HPMR-24-25/HPMR-VANGUARD/VanguardFlightComputer.kicad_pcb

## KiCad design VanguardFlightComputer.kicad_pcb (2024-11-11)

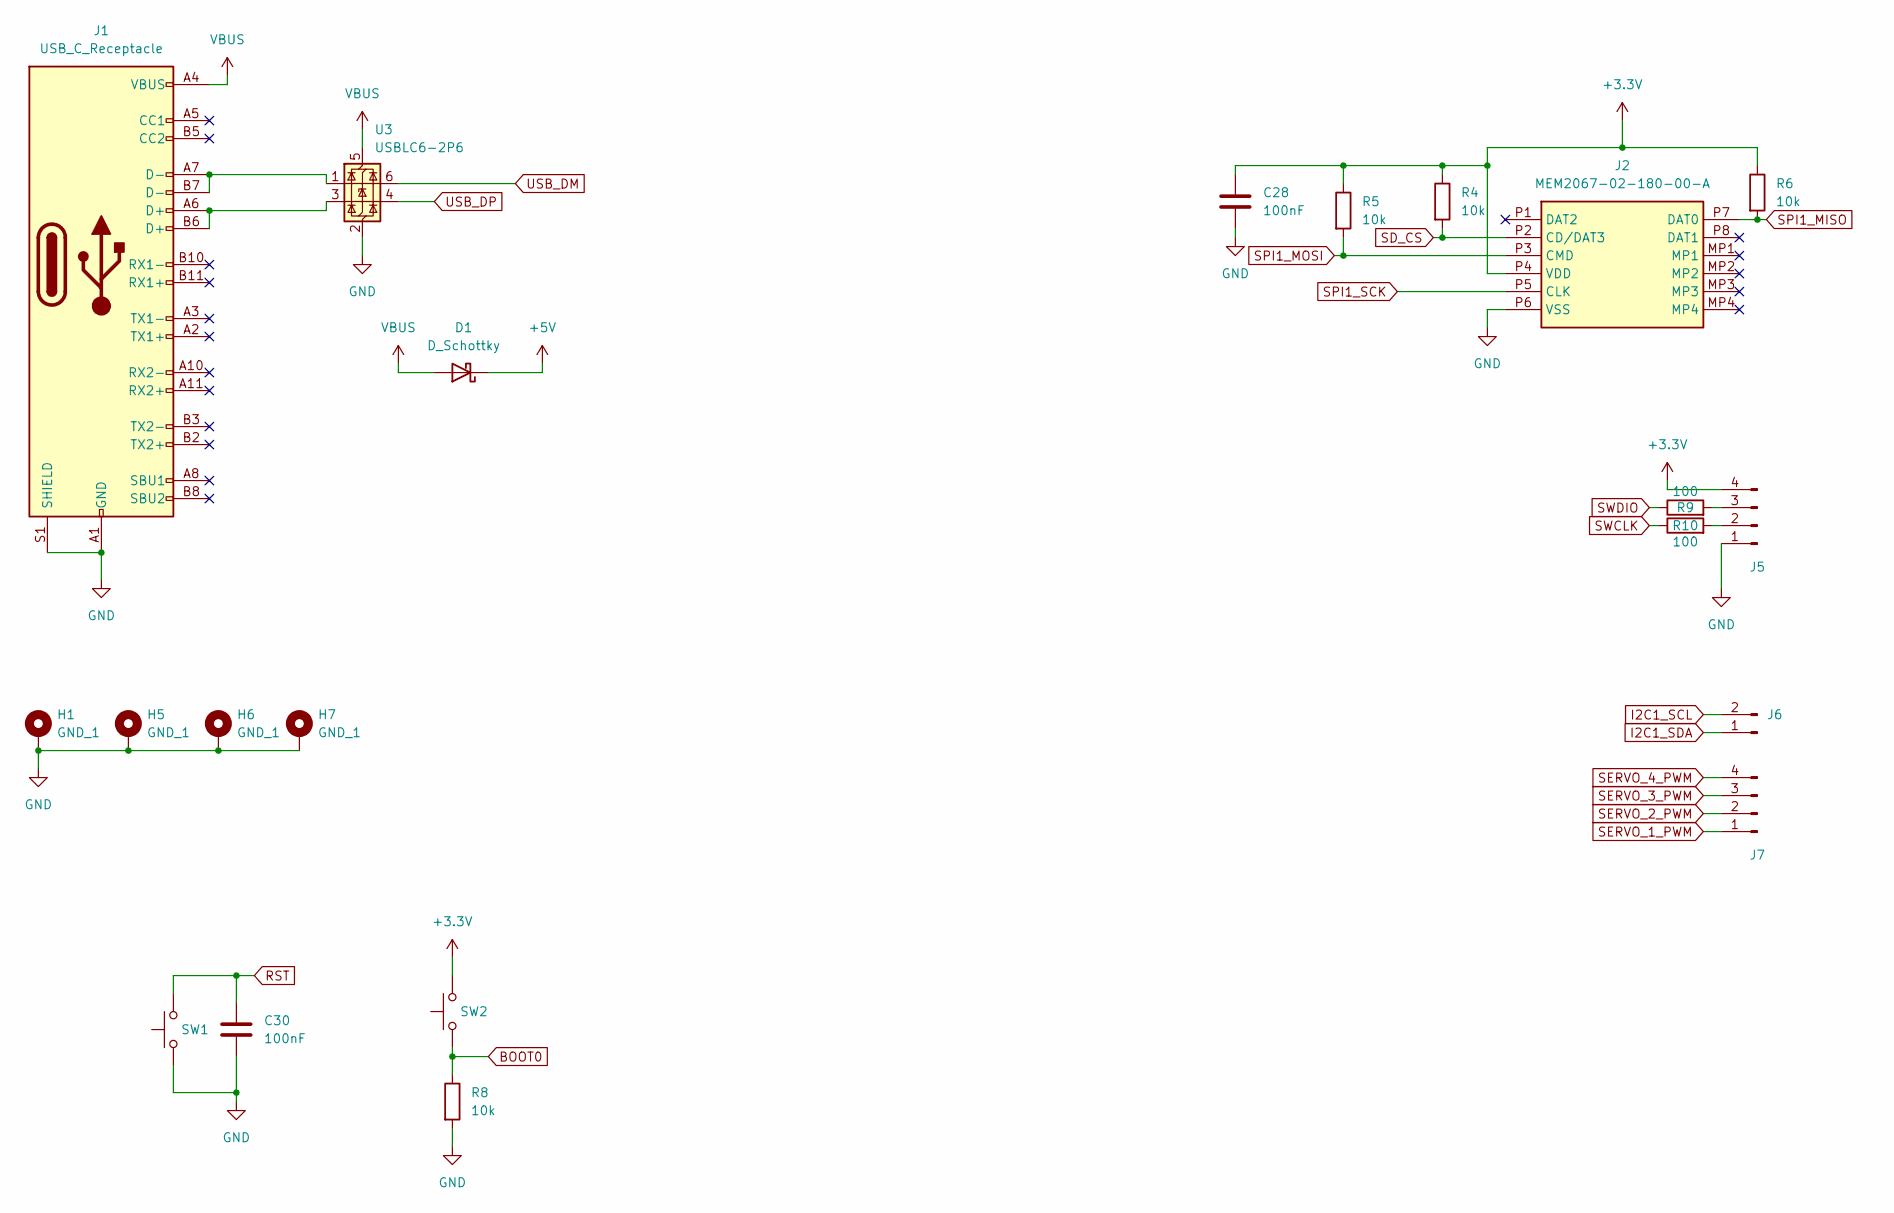
[picture p1: schematic io.kicad_sch]

Parts:
C28, C30: 100nF; C_0402_1005Metric
D1: D_Schottky; D_0402_1005Metric
H1, H5, H6, H7: GND_1; MountingHole_2.2mm_M2_DIN965_Pad_TopBottom
J1: USB_C_Receptacle; USB_C_Receptacle_Molex_105450-0101
J2: MEM2067-02-180-00-A; MEM20670218000A; Manufacturer_Part_Number MEM2067-02-180-00-A; Mouser Part Number 640-MEM20670218000A
J5, J7: Conn_01x04_Pin; PinSocket_1x04_P2.54mm_Vertical
J6: Conn_01x02_Pin; PinHeader_1x02_P2.54mm_Vertical
R4, R5, R6, R8: 10k; R_0402_1005Metric
R9, R10: 100; R_0402_1005Metric
SW1, SW2: SW_Push; SW_SPST_PTS810
U3: USBLC6-2P6; SOT-666

Connections:
+3.3V: C28.1, J2.P4 (VDD), J5.4, R4.1, R5.1, R6.1, SW2.2; also elsewhere on the board
+5V: D1.1 (K); also elsewhere on the board
BOOT0: R8.1, SW2.1; also elsewhere on the board
GND: C28.2, C30.2, H1.MP, H5.MP, H6.MP, H7.MP, J1.A1 (GND), J1.A12 (GND), J1.B1 (GND), J1.B12 (GND), J1.S1 (SHIELD), J2.P6 (VSS), J5.1, R8.2, SW1.1, U3.2 (GND); also elsewhere on the board
I2C1_SCL: J6.2; also elsewhere on the board
I2C1_SDA: J6.1; also elsewhere on the board
unnamed: J1.A6 (D+), J1.B6 (D+), U3.3 (I/O2)
unnamed: J1.A7 (D-), J1.B7 (D-), U3.1 (I/O1)
unnamed: J5.2, R10.2
unnamed: J5.3, R9.2
RST: C30.1, SW1.2; also elsewhere on the board
SD_CS: J2.P2 (CD/DAT3), R4.2; also elsewhere on the board
SERVO_1_PWM: J7.1; also elsewhere on the board
SERVO_2_PWM: J7.2; also elsewhere on the board
SERVO_3_PWM: J7.3; also elsewhere on the board
SERVO_4_PWM: J7.4; also elsewhere on the board
SPI1_MISO: J2.P7 (DAT0), R6.2; also elsewhere on the board
SPI1_MOSI: J2.P3 (CMD), R5.2; also elsewhere on the board
SPI1_SCK: J2.P5 (CLK); also elsewhere on the board
SWCLK: R10.1; also elsewhere on the board
SWDIO: R9.1; also elsewhere on the board
USB_DM: U3.6 (I/O1); also elsewhere on the board
USB_DP: U3.4 (I/O2); also elsewhere on the board
VBUS: D1.2 (A), J1.A4 (VBUS), J1.A9 (VBUS), J1.B4 (VBUS), J1.B9 (VBUS), U3.5 (VBUS)

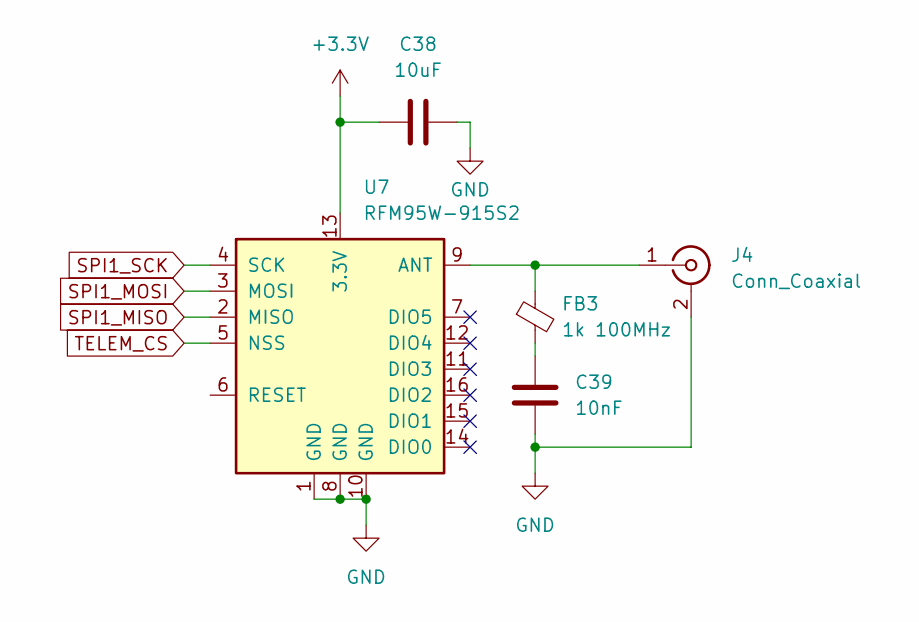
[picture p2: schematic Telemetry.kicad_sch]

Parts:
C38: 10uF; C_0402_1005Metric
C39: 10nF; C_0402_1005Metric
FB3: 1k 100MHz; C_0603_1608Metric
J4: Conn_Coaxial; U.FL_Hirose_U.FL-R-SMT-1_Vertical
U7: RFM95W-915S2; HOPERF_RFM9XW_SMD

Connections:
+3.3V: C38.1, U7.13 (3.3V); also elsewhere on the board
GND: C38.2, C39.2, J4.2 (Ext), U7.1 (GND), U7.8 (GND), U7.10 (GND); also elsewhere on the board
unnamed: C39.1, FB3.2
unnamed: FB3.1, J4.1 (In), U7.9 (ANT)
SPI1_MISO: U7.2 (MISO); also elsewhere on the board
SPI1_MOSI: U7.3 (MOSI); also elsewhere on the board
SPI1_SCK: U7.4 (SCK); also elsewhere on the board
TELEM_CS: U7.5 (NSS); also elsewhere on the board

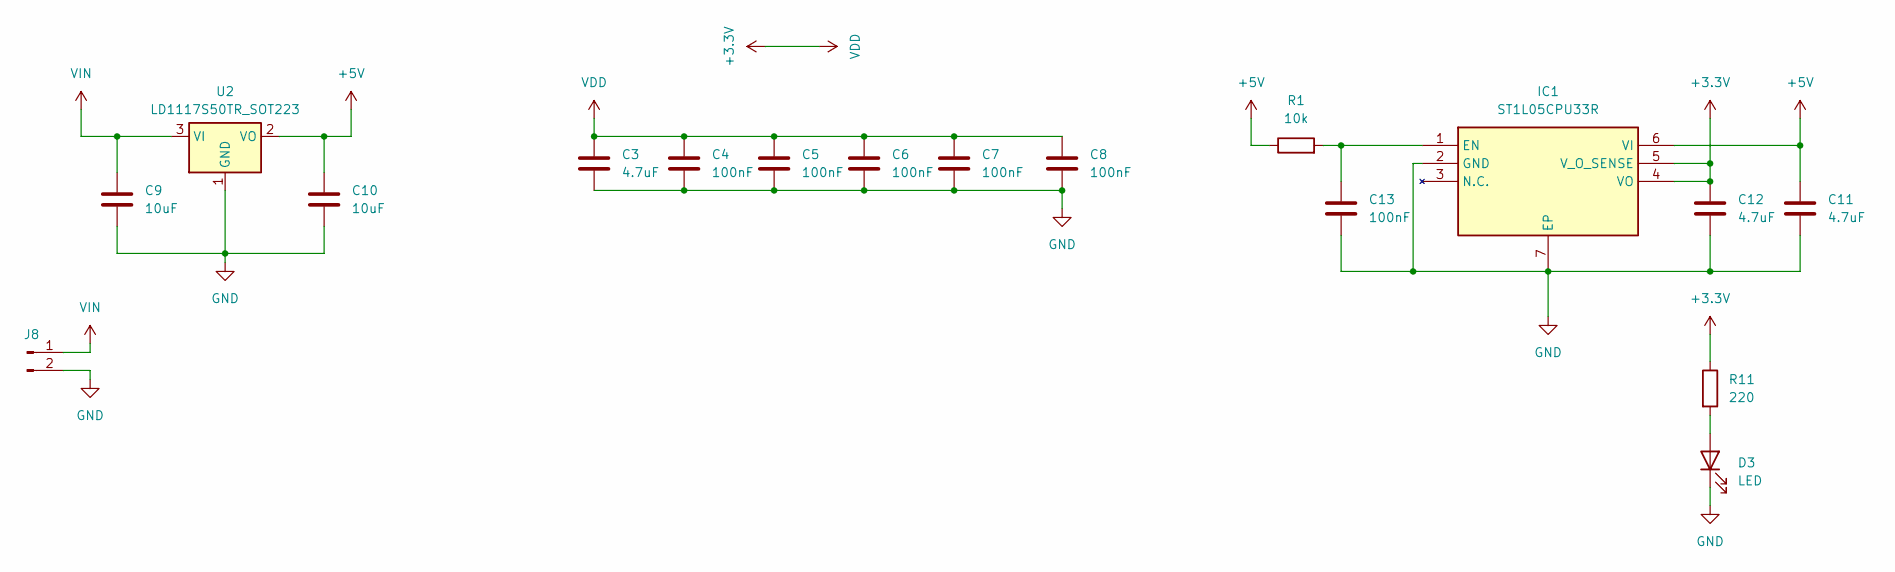
[picture p3: schematic power.kicad_sch]

Parts:
C3, C11, C12: 4.7uF; C_0402_1005Metric
C4, C5, C6, C7, C8, C13: 100nF; C_0402_1005Metric
C9, C10: 10uF; C_0603_1608Metric
D3: LED; LED_0603_1608Metric
IC1: ST1L05CPU33R; SON95P300X300X100-7N-D; Manufacturer_Part_Number ST1L05CPU33R; Mouser Part Number 511-ST1L05CPU33R
J8: Conn_01x02_Pin; PinHeader_1x02_P2.54mm_Vertical
R1: 10k; R_0603_1608Metric
R11: 220; R_0402_1005Metric
U2: LD1117S50TR_SOT223; SOT-223-3_TabPin2

Connections:
+3.3V: C3.1, C4.1, C5.1, C6.1, C7.1, C8.1, C12.1, IC1.4 (VO), IC1.5 (V_O_SENSE), R11.1; also elsewhere on the board
+5V: C10.1, C11.1, IC1.6 (VI), R1.1, U2.2 (VO); also elsewhere on the board
GND: C3.2, C4.2, C5.2, C6.2, C7.2, C8.2, C9.2, C10.2, C11.2, C12.2, C13.2, D3.1 (K), IC1.2 (GND), IC1.7 (EP), J8.2, U2.1 (GND); also elsewhere on the board
unnamed: D3.2 (A), R11.2
unnamed: C13.1, IC1.1 (EN), R1.2
VIN: C9.1, J8.1, U2.3 (VI)

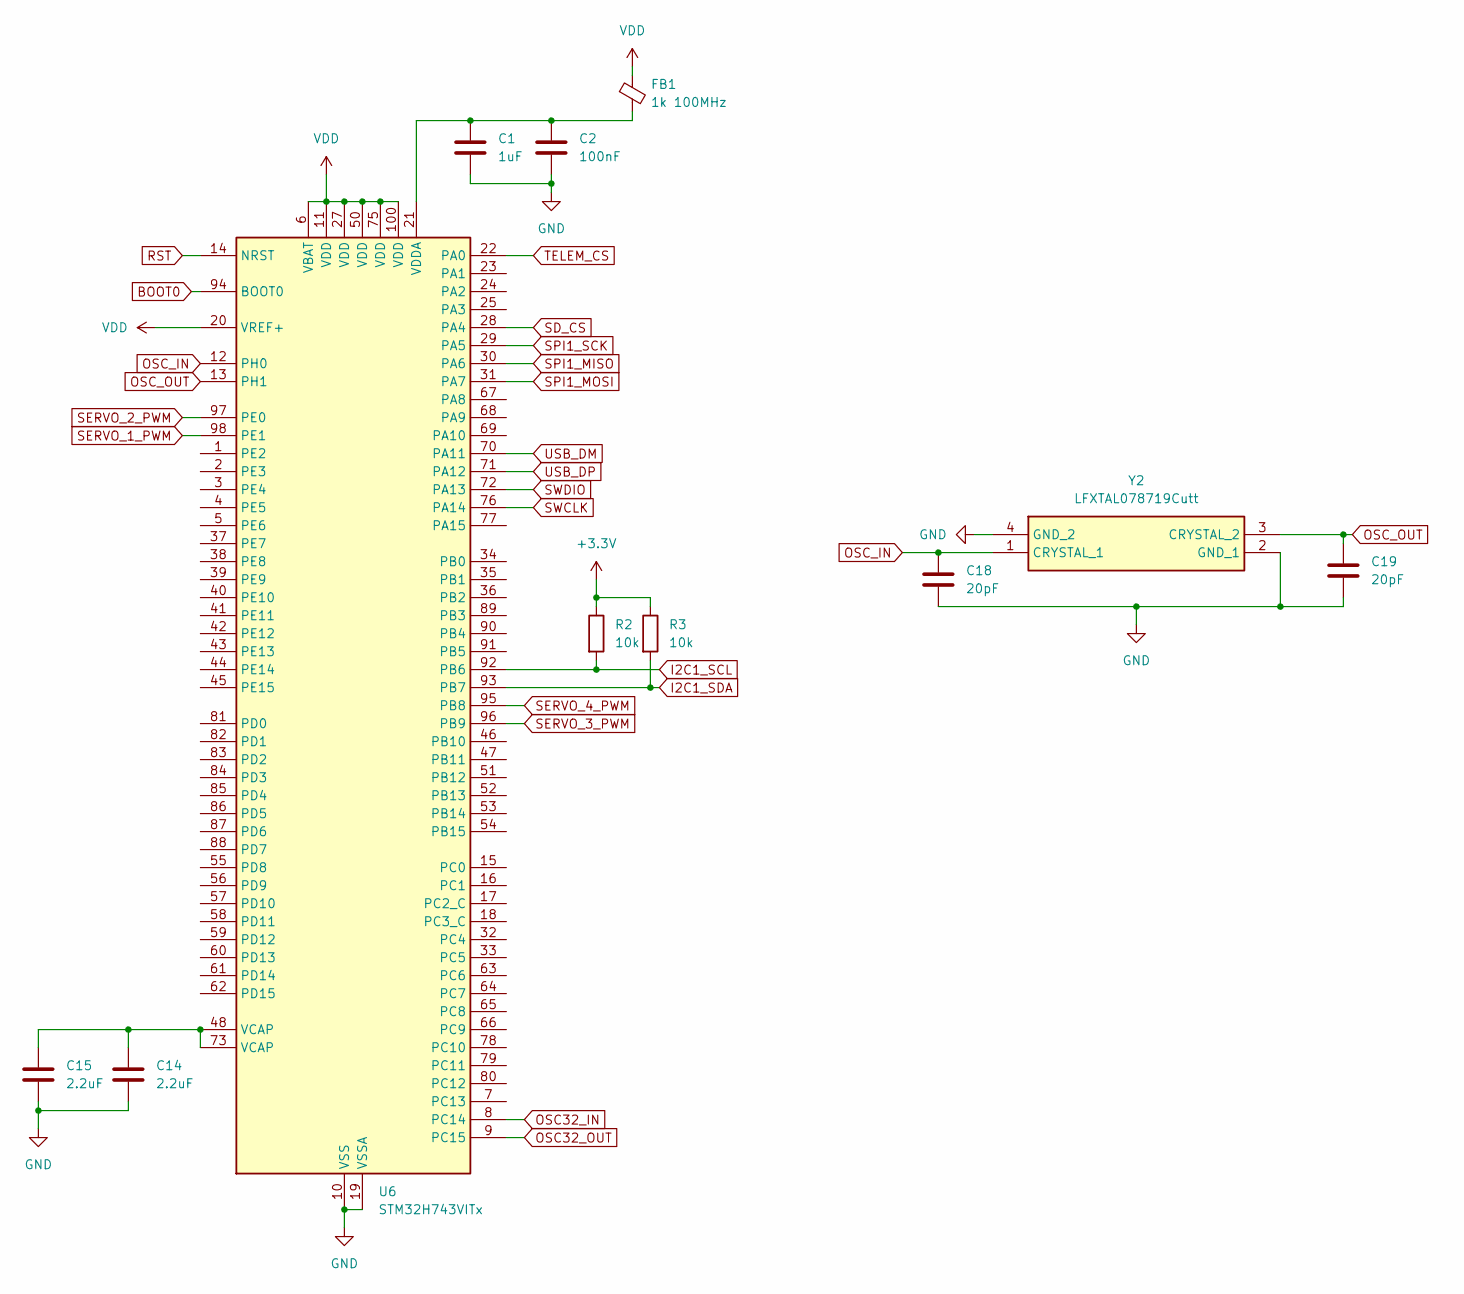
[picture p4: schematic stm32.kicad_sch]

Parts:
C1: 1uF; C_0402_1005Metric
C2: 100nF; C_0402_1005Metric
C14, C15: 2.2uF; C_0402_1005Metric
C18, C19: 20pF; C_0402_1005Metric
FB1: 1k 100MHz; C_0603_1608Metric
R2, R3: 10k; R_0402_1005Metric
U6: STM32H743VITx; LQFP-100_14x14mm_P0.5mm
Y2: LFXTAL078719Cutt; Manufacturer_Part_Number LFXTAL078719Cutt; Mouser Part Number 449-LFXTAL078719CUTT

Connections:
+3.3V: FB1.1, R2.1, R3.1, U6.6 (VBAT), U6.11 (VDD), U6.20 (VREF+), U6.27 (VDD), U6.50 (VDD), U6.75 (VDD), U6.100 (VDD); also elsewhere on the board
BOOT0: U6.94 (BOOT0); also elsewhere on the board
GND: C1.2, C2.2, C14.2, C15.2, C18.1, C19.1, U6.10 (VSS), U6.19 (VSSA), U6.26 (VSS), U6.49 (VSS), U6.74 (VSS), U6.99 (VSS), Y2.2 (GND_1), Y2.4 (GND_2); also elsewhere on the board
I2C1_SCL: R2.2, U6.92 (PB6); also elsewhere on the board
I2C1_SDA: R3.2, U6.93 (PB7); also elsewhere on the board
unnamed: C14.1, C15.1, U6.48 (VCAP), U6.73 (VCAP)
unnamed: C1.1, C2.1, FB1.2, U6.21 (VDDA)
OSC32_IN: U6.8 (PC14)
OSC32_OUT: U6.9 (PC15)
OSC_IN: C18.2, U6.12 (PH0), Y2.1 (CRYSTAL_1)
OSC_OUT: C19.2, U6.13 (PH1), Y2.3 (CRYSTAL_2)
RST: U6.14 (NRST); also elsewhere on the board
SD_CS: U6.28 (PA4); also elsewhere on the board
SERVO_1_PWM: U6.98 (PE1); also elsewhere on the board
SERVO_2_PWM: U6.97 (PE0); also elsewhere on the board
SERVO_3_PWM: U6.96 (PB9); also elsewhere on the board
SERVO_4_PWM: U6.95 (PB8); also elsewhere on the board
SPI1_MISO: U6.30 (PA6); also elsewhere on the board
SPI1_MOSI: U6.31 (PA7); also elsewhere on the board
SPI1_SCK: U6.29 (PA5); also elsewhere on the board
SWCLK: U6.76 (PA14); also elsewhere on the board
SWDIO: U6.72 (PA13); also elsewhere on the board
TELEM_CS: U6.22 (PA0); also elsewhere on the board
USB_DM: U6.70 (PA11); also elsewhere on the board
USB_DP: U6.71 (PA12); also elsewhere on the board

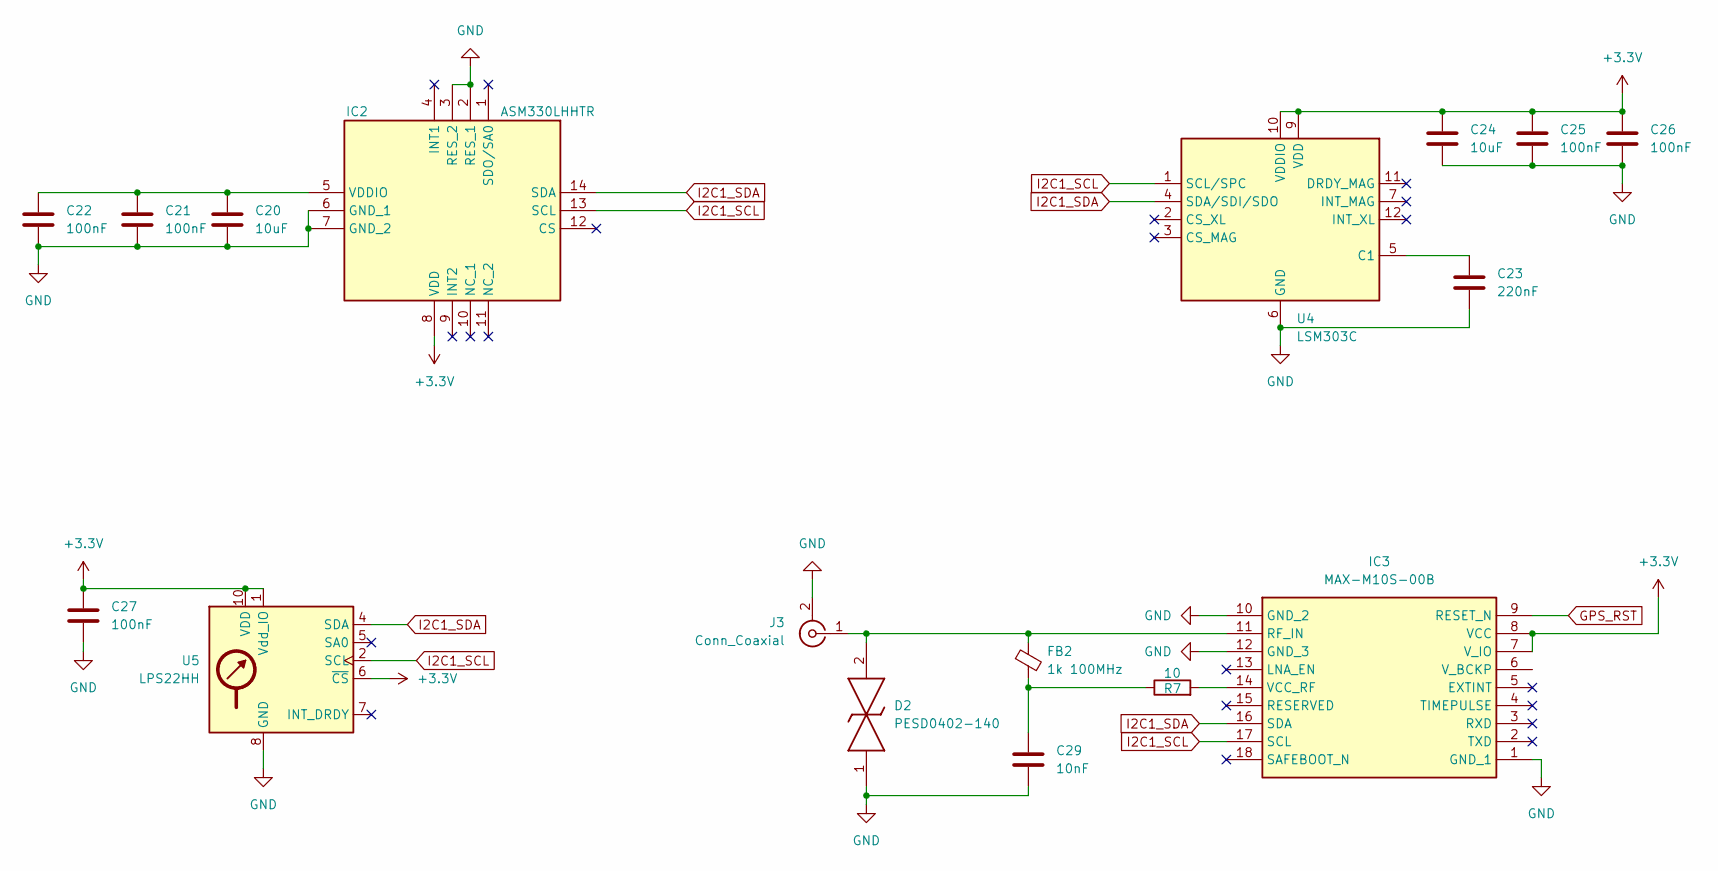
[picture p5: schematic sensors.kicad_sch]

Parts:
C20, C24: 10uF; C_0402_1005Metric
C21, C22, C25, C26, C27: 100nF; C_0402_1005Metric
C23: 220nF; C_0402_1005Metric
C29: 10nF; C_0402_1005Metric
D2: PESD0402-140; DIONC1005X43N; Mouser Part Number 650-PESD0402-140
FB2: 1k 100MHz; C_0603_1608Metric
IC2: ASM330LHHTR; LSM6DS3USTR; Manufacturer_Part_Number ASM330LHHTR; Mouser Part Number 511-ASM330LHHTR
IC3: MAX-M10S-00B; MAXM10S00B; Mouser Part Number 377-MAX-M10S-00B
J3: Conn_Coaxial; U.FL_Hirose_U.FL-R-SMT-1_Vertical
R7: 10; C_0402_1005Metric
U4: LSM303C; LGA-12_2x2mm_P0.5mm
U5: LPS22HH; ST_HLGA-10_2x2mm_P0.5mm_LayoutBorder3x2y

Connections:
+3.3V: C24.1, C25.1, C26.1, C27.1, IC2.8 (VDD), IC3.7 (V_IO), IC3.8 (VCC), U4.9 (VDD), U4.10 (VDDIO), U5.1 (Vdd_IO), U5.6 (~CS), U5.10 (VDD); also elsewhere on the board
GND: C20.2, C21.2, C22.2, C23.2, C24.2, C25.2, C26.2, C27.2, C29.2, D2.1, IC2.2 (RES_1), IC2.3 (RES_2), IC2.6 (GND_1), IC2.7 (GND_2), IC3.1 (GND_1), IC3.10 (GND_2), IC3.12 (GND_3), J3.2 (Ext), U4.6 (GND), U4.8 (GND), U5.3 (GND), U5.8 (GND), U5.9 (GND); also elsewhere on the board
GPS_RST: IC3.9 (RESET_N)
I2C1_SCL: IC2.13 (SCL), IC3.17 (SCL), U4.1 (SCL/SPC), U5.2 (SCL); also elsewhere on the board
I2C1_SDA: IC2.14 (SDA), IC3.16 (SDA), U4.4 (SDA/SDI/SDO), U5.4 (SDA); also elsewhere on the board
unnamed: C29.1, FB2.2, R7.1
unnamed: C20.1, C21.1, C22.1, IC2.5 (VDDIO)
unnamed: D2.2, FB2.1, IC3.11 (RF_IN), J3.1 (In)
unnamed: IC3.14 (VCC_RF), R7.2
unnamed: C23.1, U4.5 (C1)

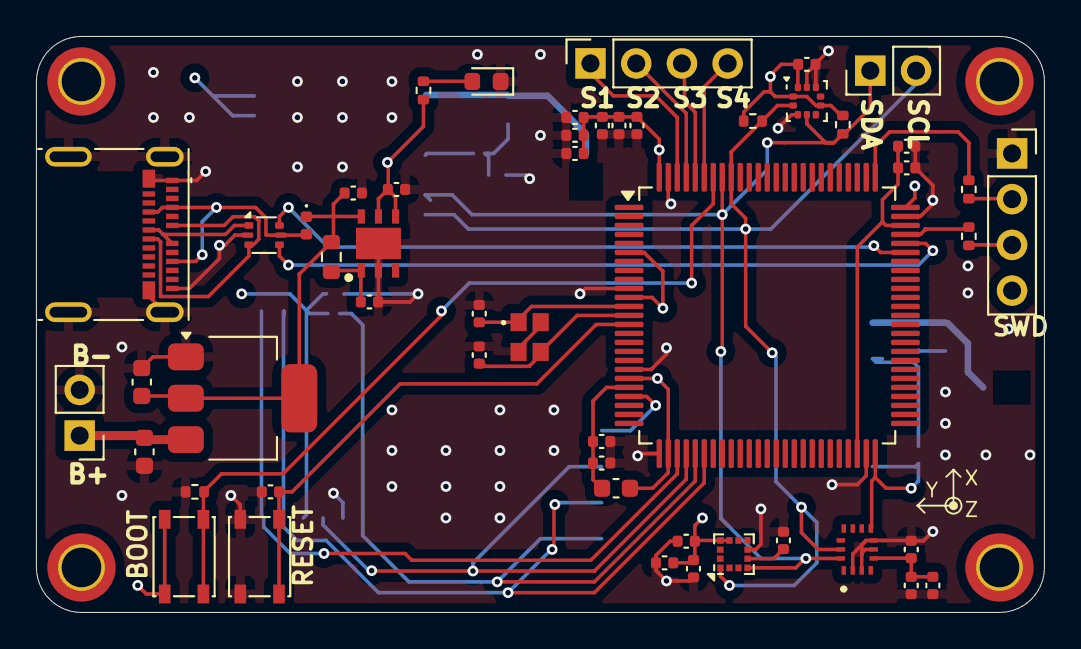
[picture p6: board VanguardFlightComputer.kicad_pcb from above]

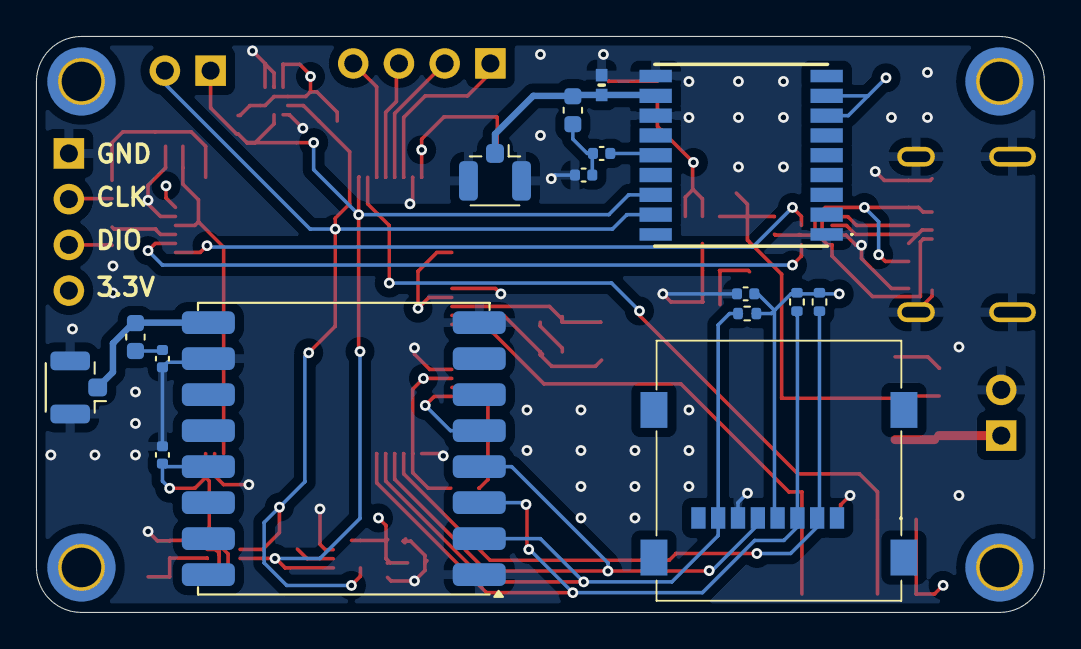
[picture p7: board VanguardFlightComputer.kicad_pcb from below]

Board: 4 copper layers, 56.0 x 32.0 mm, 71 parts (16 on the bottom side), 39 nets.
