HPMR-24-25/HPMR-VANGUARD/HPMR-VANGUARD.ioc

Mcu.UserName=STM32H743VITx
PA0.Signal=GPIO_Output
PA10.Signal=USB_OTG_FS_ID
PA11.Signal=USB_OTG_FS_DM
PA12.Signal=USB_OTG_FS_DP
PA4.Signal=GPIO_Output
PA5.Signal=SPI1_SCK
PA6.Signal=SPI1_MISO
PA7.Signal=SPI1_MOSI
PB6.Signal=I2C1_SCL
PB7.Signal=I2C1_SDA
PB8.Signal=GPIO_Output
PB9.Signal=GPIO_Output
PE0.Signal=GPIO_Output
PE1.Signal=GPIO_Output
