HPMR-24-25/HPMR-VANGUARD/(commit log)

2024-11-03 Added initial project
    [VanguardFlightComputer.kicad_pcb, VanguardFlightComputer.kicad_sch, io.kicad_sch, power.kicad_sch, sensors.kicad_sch, stm32.kicad_sch]
2024-11-03 Added all sensors and telemetry modem
    [Telemetry.kicad_sch, VanguardFlightComputer.kicad_pcb, VanguardFlightComputer.kicad_sch, io.kicad_sch, sensors.kicad_sch, stm32.kicad_sch]
2024-11-03 Fixed ground pour
    [VanguardFlightComputer.kicad_pcb]
2024-11-04 Added IO
    [VanguardFlightComputer.kicad_pcb, io.kicad_sch, sensors.kicad_sch, stm32.kicad_sch]
2024-11-05 Change 0201 to 0403
    [BillOfMaterials.csv, BillOfMaterials.xlsx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]
2024-11-08 Re-Routed PCB
    [VanguardFlightComputer.kicad_pcb]
2024-11-11 Impedence match trace
    [VanguardFlightComputer.kicad_pcb]
2024-11-11 Added STM32_MX Project, LED, Fixed DRC Violations
    [BillOfMaterials.csv, BillOfMaterials.xlsx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]
2024-11-11 Aligned IMU axes and fixed JLC match trace
    [VanguardFlightComputer-B_Cu.gbr, VanguardFlightComputer-B_Mask.gbr, VanguardFlightComputer-B_Paste.gbr, VanguardFlightComputer-B_Silkscreen.gbr, VanguardFlightComputer-Edge_Cuts.gbr, VanguardFlightComputer-F_Cu.gbr, VanguardFlightComputer-F_Mask.gbr, VanguardFlightComputer-F_Paste.gbr]
